hubwerk/Smartfitness-bridge-case/views/back.png

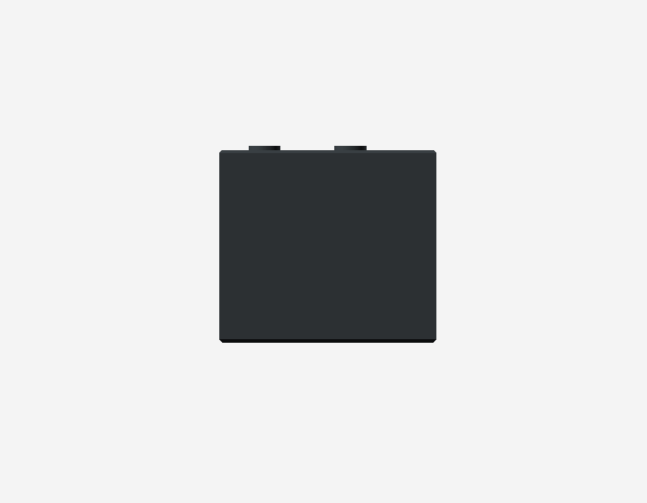
views/back.png
