hubwerk/Smartfitness-bridge-case/views/bottom.png

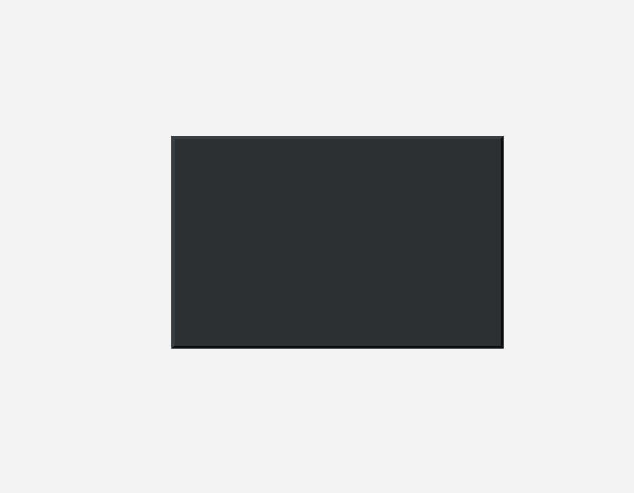
views/bottom.png
