hubwerk/Smartfitness-bridge-case/views/electronics/exploded.png

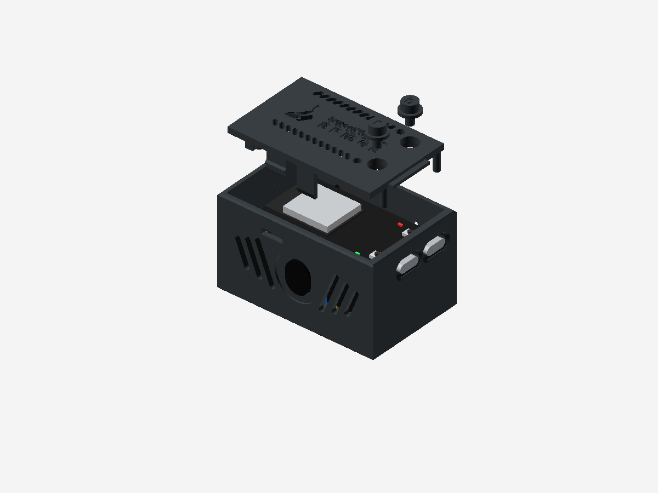
views/electronics/exploded.png
