hubwerk/Smartfitness-bridge-case/views/electronics/front_usb.png

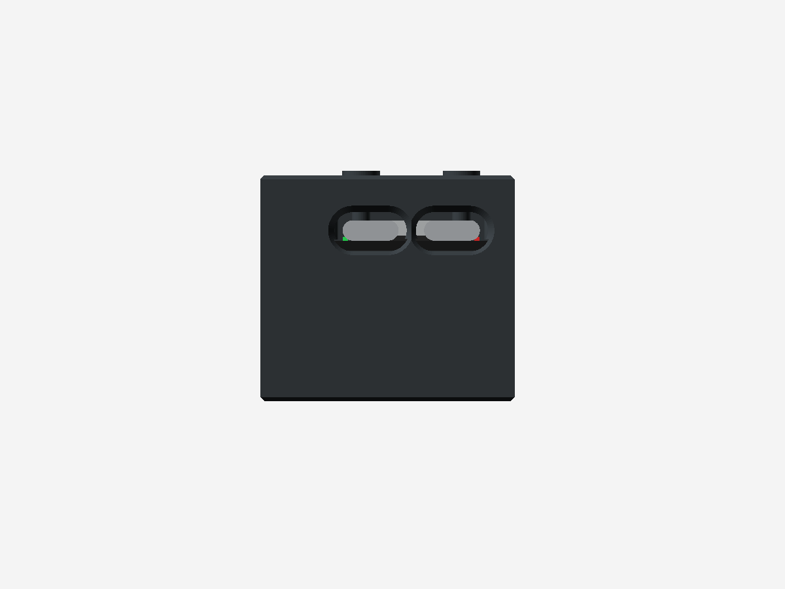
views/electronics/front_usb.png
