hubwerk/Smartfitness-bridge-case/views/electronics/open_iso_back.png

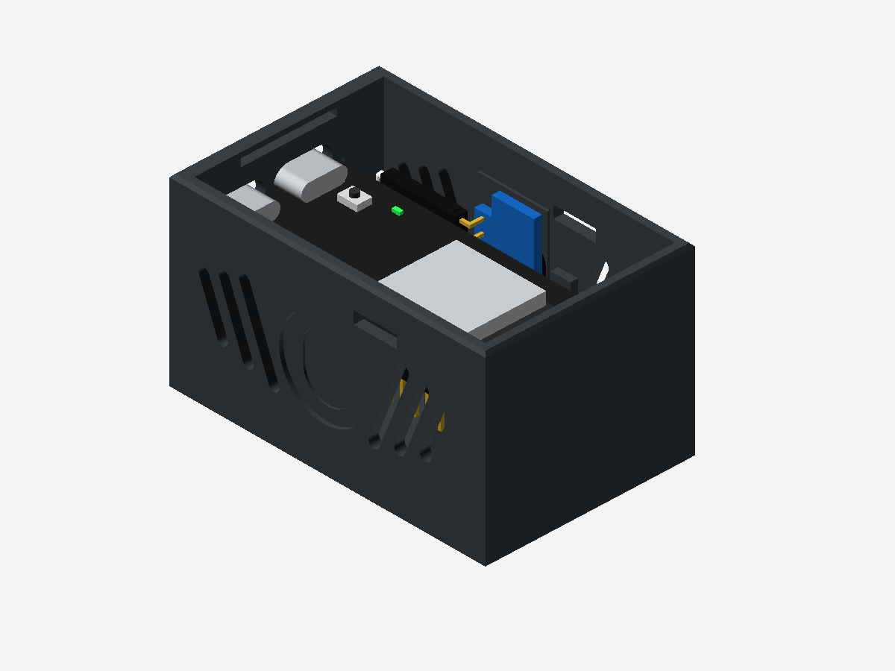
views/electronics/open_iso_back.png
