hubwerk/Smartfitness-bridge-case/views/electronics/open_iso_sensor.png

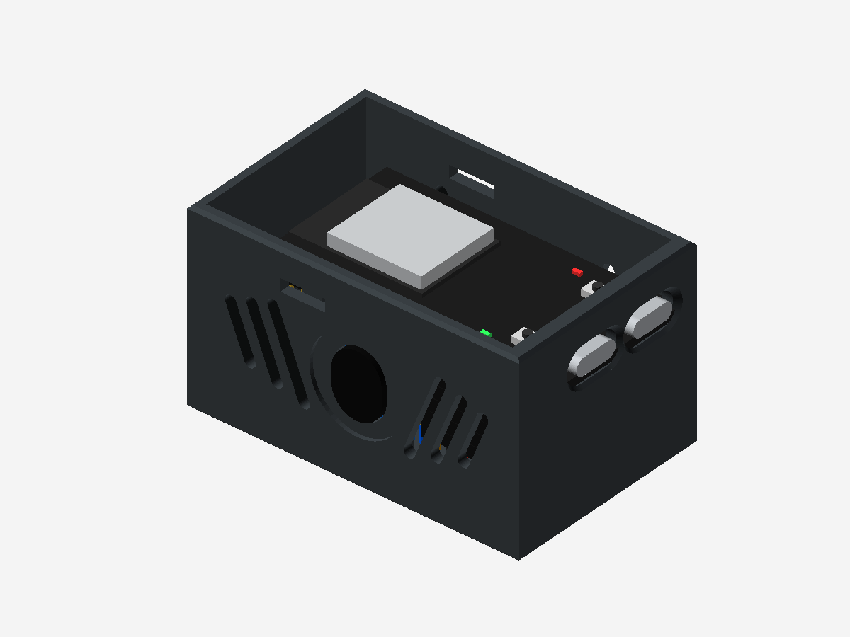
views/electronics/open_iso_sensor.png
