hubwerk/Smartfitness-bridge-case/views/electronics/open_top.png

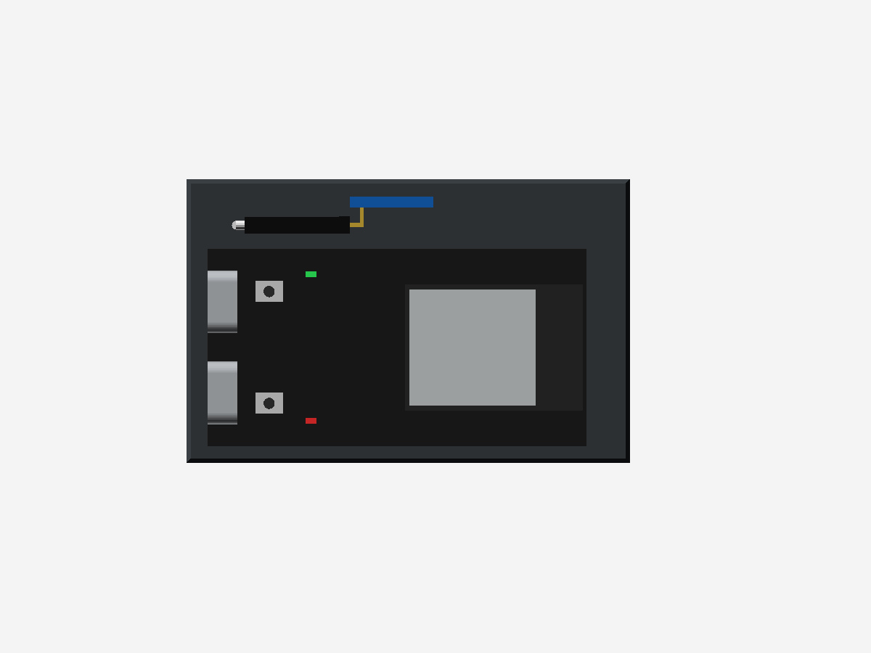
views/electronics/open_top.png
