hubwerk/Smartfitness-bridge-case/views/iso_back.png

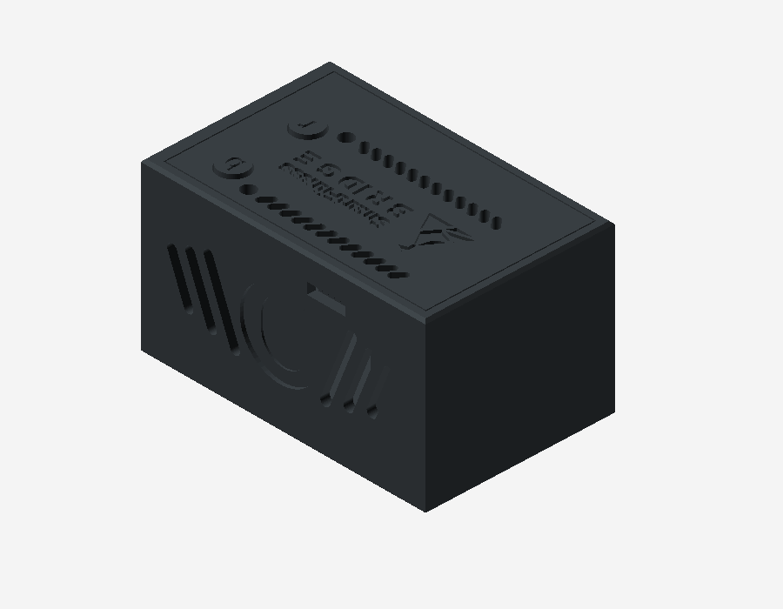
views/iso_back.png
