hubwerk/Smartfitness-bridge-case/views/iso_front.png

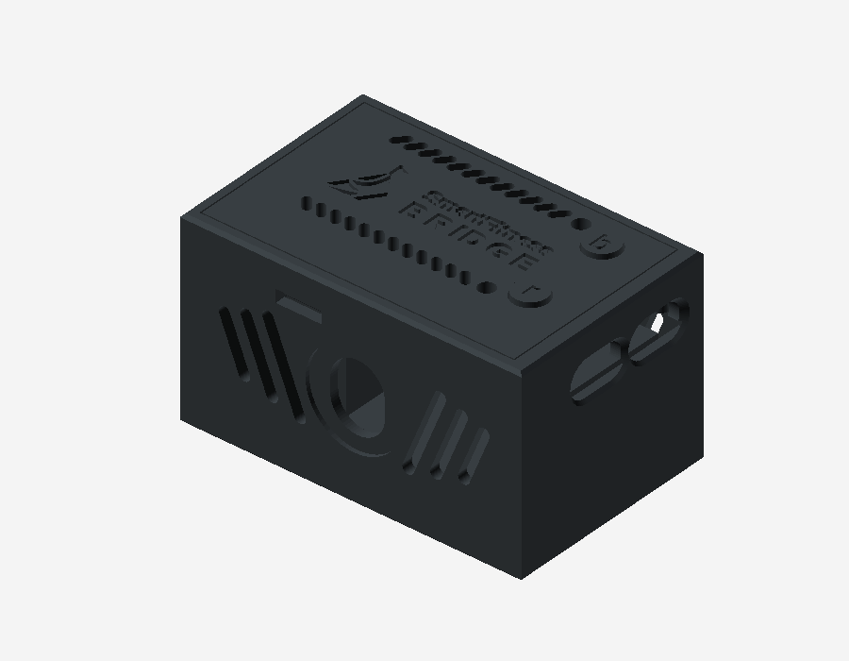
views/iso_front.png
