hubwerk/Smartfitness-bridge-case/views/left.png

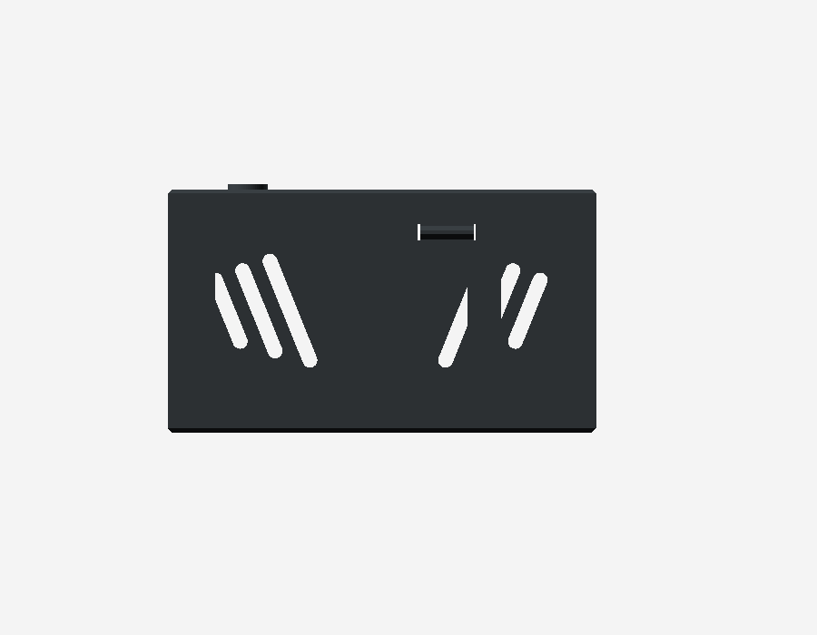
views/left.png
