hubwerk/Smartfitness-bridge-case/views/top.png

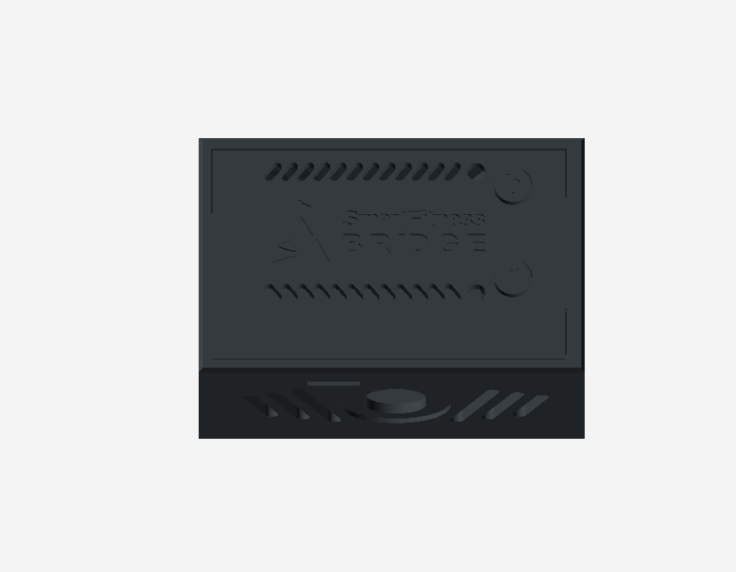
views/top.png
