hubwerk/Smartfitness-bridge-case/enclosure_lid.stl

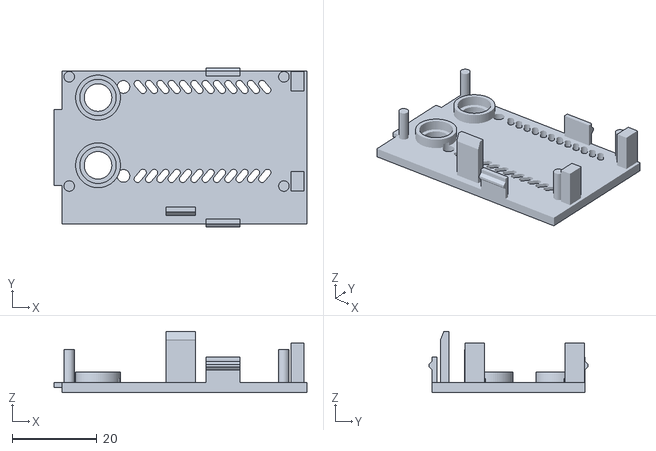
[picture p15: CAD file, 2026-11-13]
enclosure_lid.stl
59.8 x 37.6 x 14.5
