hubwerk/Smartfitness-bridge-case/button_b.stl

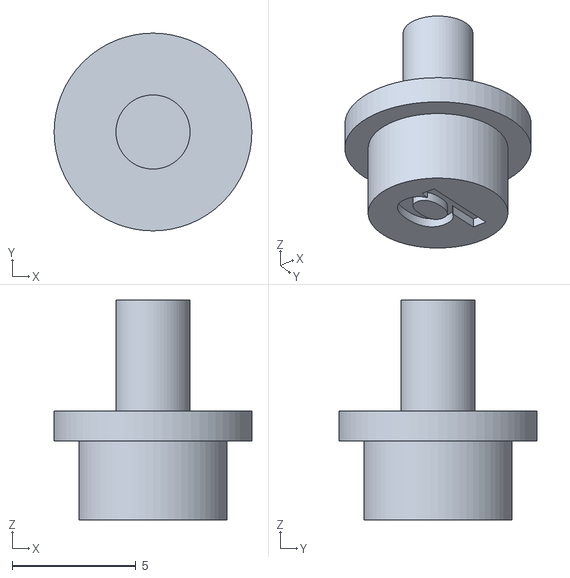
[picture p16: CAD file, 2026-11-13]
button_b.stl
8.00 x 8.00 x 8.90
