hubwerk/Smartfitness-bridge-case/enclosure_base.stl

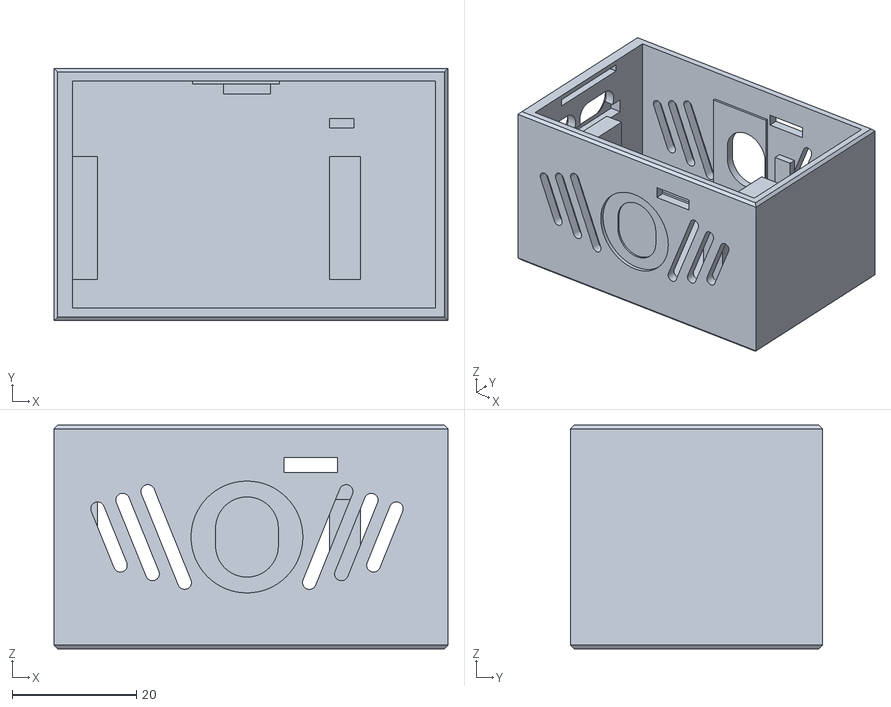
[picture p17: CAD file, 2026-11-13]
enclosure_base.stl
63.4 x 40.6 x 36.0
