hubwerk/Smartfitness-bridge-case/logo_smartfitness.scad

// automatisch erzeugt aus src/variants/web/assets/index.html (hubwerk/Smartfitness-bridge)
// Koordinaten in SVG-Einheiten, y gespiegelt
logo_mountain_1 = [[1.000,-34.000],[22.000,-4.000],[30.000,-17.000],[18.000,-34.000]];
logo_mountain_2 = [[21.000,-34.000],[32.000,-19.000],[40.000,-34.000]];
logo_road = [[0.000,-34.300],[15.600,-29.700],[16.535,-29.431],[17.431,-29.172],[18.275,-28.920],[19.052,-28.674],[19.748,-28.431],[20.350,-28.188],[20.844,-27.942],[21.215,-27.693],[21.450,-27.436],[21.535,-27.170],[21.456,-26.892],[21.200,-26.600],[20.917,-26.412],[20.572,-26.244],[20.169,-26.091],[19.711,-25.948],[19.203,-25.811],[18.650,-25.675],[18.055,-25.535],[17.422,-25.385],[16.756,-25.222],[16.061,-25.040],[15.341,-24.834],[14.600,-24.600],[13.876,-24.363],[13.205,-24.149],[12.591,-23.948],[12.037,-23.756],[11.547,-23.563],[11.125,-23.363],[10.773,-23.148],[10.496,-22.911],[10.297,-22.645],[10.179,-22.343],[10.145,-21.997],[10.200,-21.600],[10.372,-21.277],[10.677,-21.000],[11.097,-20.756],[11.615,-20.533],[12.213,-20.319],[12.875,-20.100],[13.583,-19.865],[14.319,-19.600],[15.066,-19.294],[15.806,-18.933],[16.524,-18.506],[17.200,-18.000],[17.959,-17.232],[18.639,-16.343],[19.244,-15.350],[19.778,-14.274],[20.245,-13.134],[20.650,-11.950],[20.997,-10.741],[21.289,-9.526],[21.531,-8.325],[21.728,-7.157],[21.883,-6.043],[22.000,-5.000]];
logo_road_w = 2.2;
logo_pole = [[22.000,-4.500],[22.000,3.500]];
logo_pole_w = 1.2;
logo_flag = [[22.600,3.500],[29.000,1.000],[22.600,-1.500]];
logo_bbox = [[0,-34.3],[40,3.5]];
