hubwerk/Smartfitness-bridge-case/(list of files, cad)

Other CAD files:
button_r.stl
