hubwerk/Smartfitness-bridge-case/(commit log)

2026-11-07 SmartFitness Bridge enclosure (ESP32-S3 + TOF400C)
    [deckel_logo_einlage.stl, gehaeuse.scad, gehaeuse_deckel.stl, gehaeuse_unterteil.stl, logo_smartfitness.scad, taster_b.stl, taster_r.stl]
2026-11-07 Rename files and folders to English
    [button_b.stl, button_r.stl, enclosure.scad, enclosure_base.stl, enclosure_lid.stl, lid_logo_inlay.stl]
2026-11-07 Chamfer USB openings, hide electronics in renderings
    [enclosure.scad, enclosure_base.stl]
2026-11-07 Orient lid lettering to be readable from the sensor side
    [button_b.stl, button_r.stl, enclosure.scad, enclosure_lid.stl, lid_logo_inlay.stl]
2026-11-07 Align lid vents and logo with buttons and LED openings
    [enclosure.scad, enclosure_lid.stl, lid_logo_inlay.stl]
2026-11-07 Add renderings with electronics (open, exploded, sections)
    [enclosure.scad]
2026-11-07 Raise enclosure by 6 mm for Dupont wire bends, step rear corbel to clear module
    [button_b.stl, button_r.stl, enclosure.scad, enclosure_base.stl, enclosure_lid.stl]
2026-11-07 Reduce wire bend space under Dupont plugs to 5.5 mm (case height 36 mm)
    [button_b.stl, button_r.stl, enclosure.scad, enclosure_base.stl, enclosure_lid.stl]
2026-11-08 Keep 15 mm antenna clearance: replace rear M3 screws with plastic side latches
    - No screws or metal near the WROOM antenna; antenna end 6.7 mm from the outer rear wall
    - Board support and latch moved out of the antenna area
    - Use only the first 13 pins per row from the USB end; distances checked by echo/assert
    - Add antenna clearance zone rendering
    [button_b.stl, button_r.stl, enclosure.scad, enclosure_base.stl, enclosure_lid.stl]
2026-11-08 Use Freenove board size 57.2 x 28.2 x 15 mm
    - Board length/width from the Freenove spec; pin rows assumed 25.4 mm apart
    - Sensor shifted 0.65 mm toward USB to keep 15 mm antenna clearance
    - Sensor wires bend down behind the plugs (18 mm plug space)
    - Use first 12 pins per header row; case now 63.4 x 40.6 x 36 mm
    [button_b.stl, button_r.stl, enclosure.scad, enclosure_base.stl, enclosure_lid.stl, lid_logo_inlay.stl]
2026-11-09 Lid lettering: equal width for SmartFitness and BRIDGE, flush with LED holes
    [button_b.stl, button_r.stl, enclosure.scad, enclosure_base.stl, enclosure_lid.stl, lid_logo_inlay.stl]
2026-11-13 Enlarge USB-C openings by 1 mm all around after test print
    [button_r.stl, enclosure.scad, enclosure_base.stl, enclosure_lid.stl]
2026-11-13 Remove lid logo inlay; larger and bolder lid lettering
    [button_b.stl, button_r.stl, enclosure.scad, enclosure_base.stl, enclosure_lid.stl, lid_logo_inlay.stl]
